ziyadash/si4713-fm-transmitter/(commit log)

2026-10-19 Bluetooth FM transmitter: ESP32 A2DP sink to Si4713
    Phone streams music over Bluetooth A2DP to an ESP32 (WROOM-32). The audio
    goes out of the DAC into a Si4713, which broadcasts it on FM with RDS.
    - Own Si4713 driver: tune, power, mono/stereo, noise scan, ASQ, RDS
    - Radio service with health check and automatic recovery after chip resets
    - A2DP sink with AVRCP track info sent as RDS RadioText
    - Own HD44780-over-PCF8574 LCD driver on a separate I2C bus (20x4 display)
    - BOOT button toggles the LCD; serial bring-up console for the radio
    - Modules grouped under src/ by job; README with pins, datasheet notes
    and LCD screenshots
    [app.cpp, bringup.cpp]
2026-10-19 Add circuit schematic
2026-10-21 Switch to the PCM5102A on I2S and mono transmission
2026-10-21 Document the PCM5102A wiring, mono and antenna notes
